gaduffl/ee02-eink-frame/docs/images/frame.png

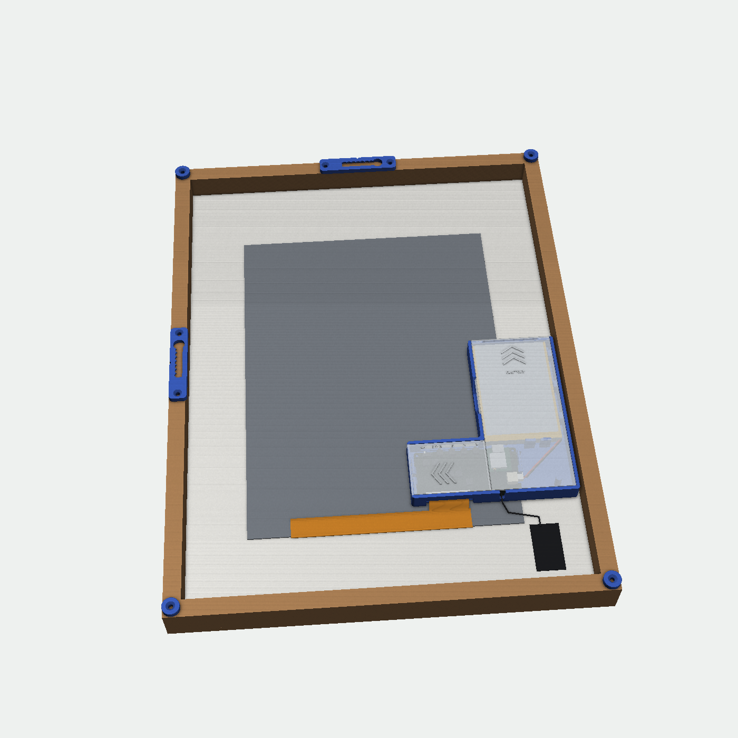
docs/images/frame.png
