gaduffl/ee02-eink-frame/docs/images/photos/social-preview.jpg

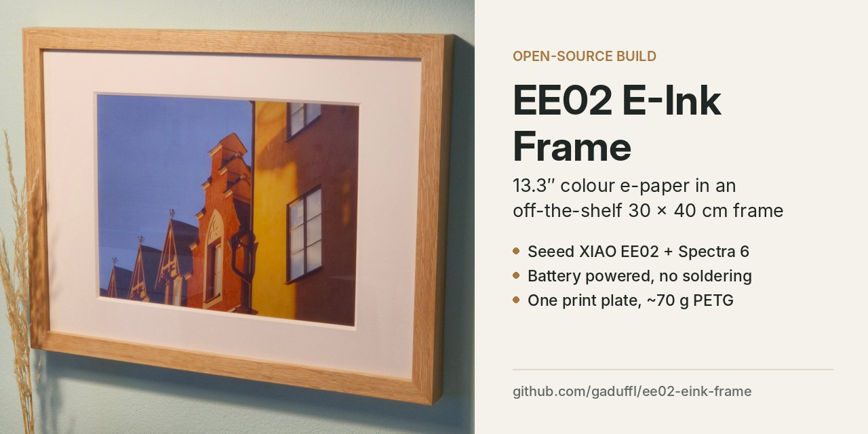
docs/images/photos/social-preview.jpg
