gaduffl/ee02-eink-frame/print/ee02_case_P1S_plate.3mf

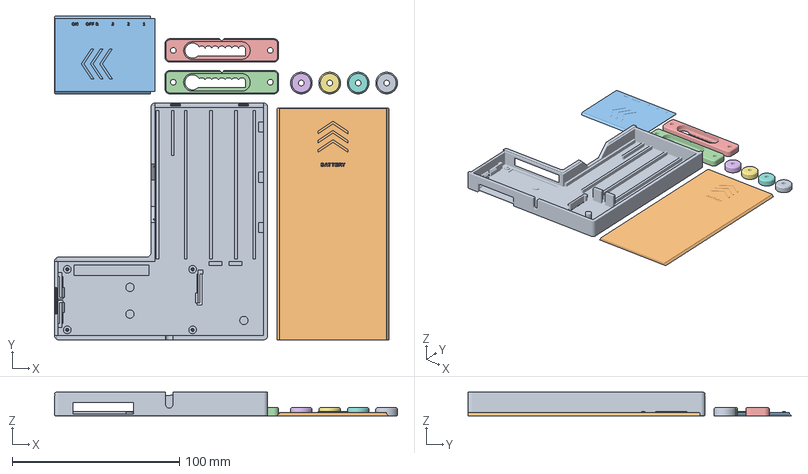
[picture p9: CAD file, 2026-10-16]
print/ee02_case_P1S_plate.3mf
205.0 x 193.5 x 14.2 mm
tray
lid_battery
lid_board
hanger_portrait
hanger_landscape
bumper_1
bumper_2
bumper_3
bumper_4
