gaduffl/ee02-eink-frame/step/bumper.step

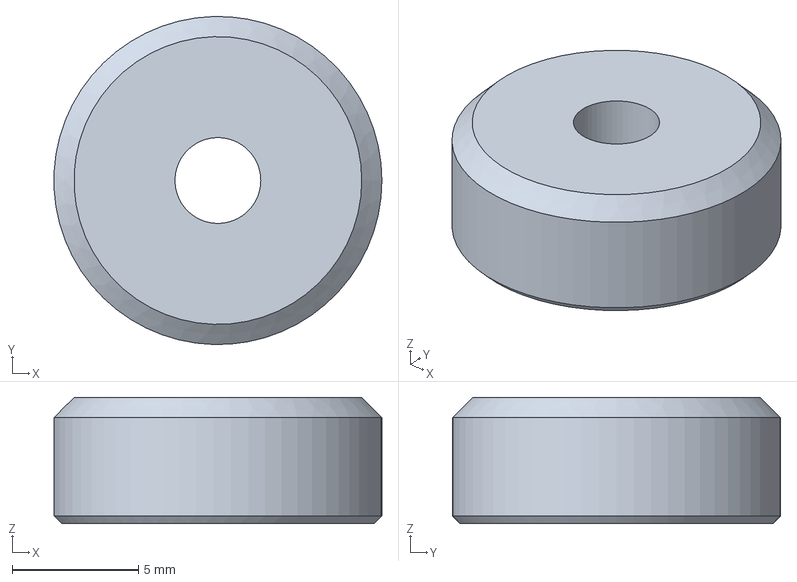
[picture p10: CAD file, 2026-10-16]
step/bumper.step
13.0 x 13.0 x 5.00 mm
