gaduffl/ee02-eink-frame/step/hanger.step

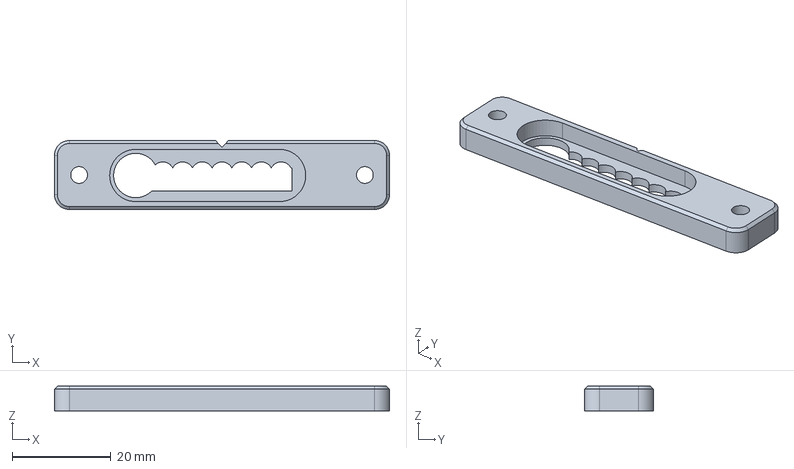
[picture p11: CAD file, 2026-10-16]
step/hanger.step
68.0 x 14.0 x 5.00 mm
