gaduffl/ee02-eink-frame/step/lid_battery.step

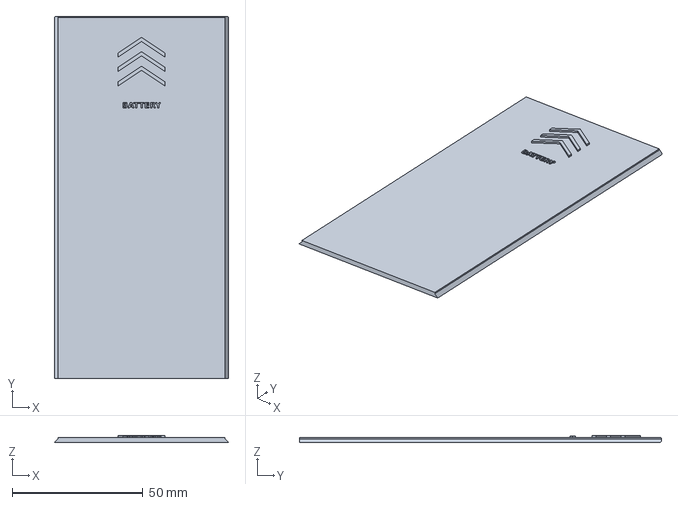
[picture p12: CAD file, 2026-10-16]
step/lid_battery.step
66.8 x 138.7 x 2.69 mm
