gaduffl/ee02-eink-frame/step/lid_board.step

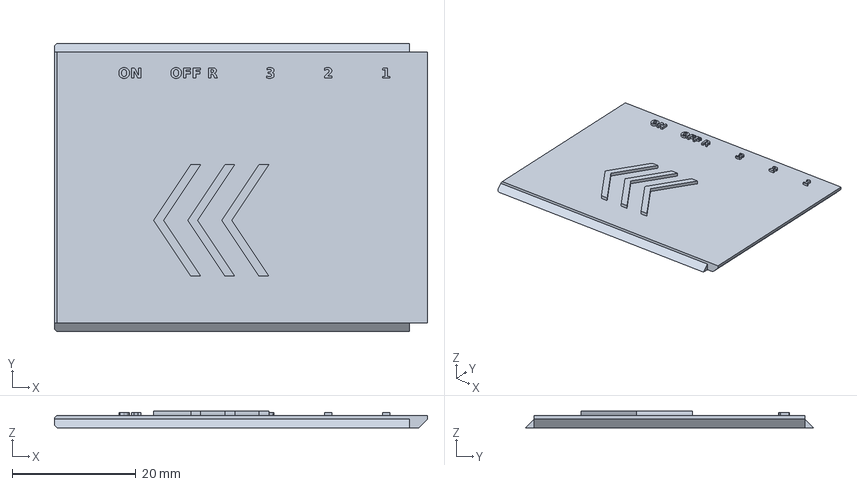
[picture p13: CAD file, 2026-10-16]
step/lid_board.step
60.2 x 46.5 x 2.69 mm
