gaduffl/ee02-eink-frame/step/tray.step

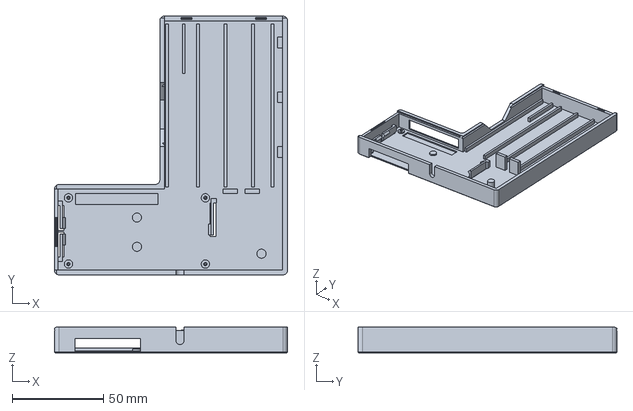
[picture p14: CAD file, 2026-10-16]
step/tray.step
127.4 x 141.6 x 14.2 mm
