gaduffl/ee02-eink-frame/(list of files, cad)

Other CAD files:
stl/bumper.stl
stl/hanger.stl
stl/lid_battery.stl
stl/lid_board.stl
stl/tray.stl
