gaduffl/ee02-eink-frame/(commit log)

2026-10-16 EE02 e-ink frame, Rev B
    Tape-on 3D-printed case for the Seeed XIAO ePaper EE02 and the 13.3"
    E Ink Spectra 6 panel in a boesner Quadro 30 x 40 cm frame: battery
    pocket with sliding lid, flexible board clips, 45 mm key/switch
    opening, portrait and landscape wall hangers. CadQuery source, STEP,
    STL and a Bambu Lab P1S plate. Firmware: aitjcize/esp32-photoframe.
    Claude-Session: https://claude.ai/code/session_01UBgm4yTTAsZVM8k2mRhDsL
    [bumper.step, bumper.stl, ee02_case_P1S_plate.3mf, hanger.step, hanger.stl, lid_battery.step, lid_battery.stl, lid_board.step]
2026-10-16 Parts list with Amazon links, back-board notch
    - parts/parts.toml + parts/render.py generate the README parts table with
    links for amazon.com, amazon.de and amazon.fr; tracking IDs live in
    parts/affiliate.toml and switch on the Associates disclosure
    - back board: notch drawing (docs/images/back-board.svg) and assembly
    steps; the battery lid slides out over the board
    - LiPo charger for the spare battery
    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
2026-10-16 Parts list: Seeed EE02 kit for board and panel
    Recommend the Seeed XIAO ePaper DIY Kit EE02 (board + tested 13.3"
    Spectra 6 panel) instead of a third-party panel from Amazon.
    parts/affiliate.toml gets a [seeed] section for tracking links from the
    Seeed affiliate dashboard; the disclosure mentions Seeed when it is set.
    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
2026-10-16 Set affiliate ID for amazon.de
    Updated the affiliate ID for the amazon.de account.
2026-10-16 Parts list: OpenELAB links for the EE02 board and display
    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
2026-10-16 Parts list: remove the LiPo charger
    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
2026-10-16 Parts list: one battery, listed cells untested
    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
2026-10-17 Photos of the finished frame, corner notch in the back board
    Real photos replace the hero render (dashboard on the wall, back with
    lids on and open). The back-board notch runs to the bottom edge like the
    real build (133 x 217 mm); the back board's own hangers are an option.
    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
2026-10-17 Photo of the frame as the main picture, 706090 battery
    - New main picture: the frame showing one of my photos.
    - Dashboard photo moved next to the back photos.
    - Battery: the tested cell is a 706090 (3.7 V, 5000 mAh, measured
    60.5 x 91 x 6.5 mm). Amazon searches for 706090; the 606090 listings
    stay as an alternative that fits the same pocket.
    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
2026-10-17 README: affiliate notes in small print at the end
    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
2026-10-17 README: mark affiliate links with *, unchecked listings with †
    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
2026-10-18 README: cost estimate, no-soldering note, social preview image
    Claude-Session: https://claude.ai/code/session_012v66ktRaCBnT7HkCGwaGE7
